ko-tyat-ki/universal-ear/static/images/desert.jpeg

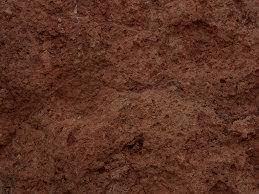
static/images/desert.jpeg
