ko-tyat-ki/universal-ear/static/images/moon.png

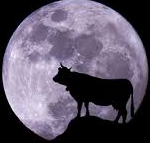
static/images/moon.png
