ko-tyat-ki/universal-ear/(commit log)

2019-02-23 Add initial arduino setup
    Reads data from the sensor, prints sensor to 9600, changes LEDs
    based on the information received from the sensor.
2019-02-23 PI Server + Arduino in passive mode
2019-02-25 Add server and refactor code
    Server runs on express with very minimal set up for now;
    Function connectArduinoWithColumn connects Arduino
    simulation with the drawn columns;
    Program is beign run on the closure.
2019-02-26 Two arduinos sends and receives through pi
    Sensors send information to pi and LEDs receive information from pi
    Two way communication!
2019-02-27 Add a switch to html
    Offers two options and does nothing.
2019-02-27 Increase number of LEDs to 40
2019-02-27 Introduce switch that listens to the dropdown value
2019-02-27 Separate basic function
    Now basic function works when the option is selected.
    Class column draws leds based on provided array of objects with
    { number, color } values.
2019-02-27 Update app.ino
    Arduino. Added averaging functions and sensor derivatives. Requires testing
2019-03-03 Arduino. Running average calculation for sensor value. Web. Flicker values.
    Revert "Revert "Update app.ino""
    This reverts commit d404375da9c8d9e6f374489f315d1ebb58280242.
    Revert "Revert "Added Flicker function""
    This reverts commit e40feee27a2ab2055a29b3580251ce642469ade0.
2019-03-03 First draft of client-server socket com
    Between python and pi server.js
2019-03-03 Add random echo
    Flickers on the column with the active sensor, and echos to other
    columns.
2019-03-03 Sensor interface added
2019-03-03 Add pi-brain/deives prototype
2019-03-21 Add heights to columns
    That correspond to sensors height.
    Basic function runs from that height.
2019-03-23 Tension and random echo (#16)
    * Initial commit for random tension with echo
    * Make them all the same brightness
2019-03-23 Server to process everything
    - added nodejs watcher to check for lates changes and restart server
    - added socket server to process sensor ignals and output led values
    - added babel to be able to write serverside and clientside logic in same dialect
    - moved client logic partially to serverside
    - separated static files from business logic
    - rewrote basic effect to comply
2019-03-23 Fix merges (#17)
    * fix random echo
    * fix tension and random tension
2019-05-19 3d visualisation for Poles (#20)
    * First step: copy example
    It works!
    Still lots of todos, from color picker, to connecting columns
    and lightning them up.
    * Looks like desert with LED lights
    * Tiny code remarks
    * Replace light with balls
    Can change color dynamiclly now
    Maybe will have to replce with something else
    Like small tube?
    * 3d reacts to keys!!! ♥️
    * Refactor
    Rename classes
    * Tiny refactoring
    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
2019-06-06 Added raspberrypi setup settings Deployment key for raspberrypi Lost Fastled lib for arduino
2019-06-06 * arduino reading * collection and preparation for processing * no web interface notification for now
2019-06-06 Arduino writes all data to output and reads l and c commands to set led to specific color Stuck with node infinite loop not giving execution time to serialport library
    [app-new.ino]
2019-06-06 Sensors katya (#19)
    * intermediary commit
    working:
    - client -> server
    - arduino -> console
    ???
    - arduino -> server
    - combine data
    * Intermediary commit
2019-06-06 Trying to make things work together Sirnyk driven development Now we read and write to arduino, BUT write works badly
2019-06-06 When we send 1 led on or off
2019-06-06 Clean leds every time
2019-06-06 Arduino byte arrays
    Arduino ping-pong with byte arrays.
2019-06-06 Bytearray ping-pong implementation
    Both arduino and node
    * for 3 leds
    * no checksum, no size yet
2019-06-06 Increase number of leds, add endbyte
2019-06-06 Bytearray ping-pong comms with 10 leds
    * 10 leds now, potential to increase up
2019-06-06 bytearray pingpong for 30 leds
2019-06-06 40 leds with only colors
2019-06-06 Output sensor data
2019-06-06 40 LEDs on the stick
2019-06-06 Adjust randomEcho and tensionAndRandomEcho
2019-06-06 You can see real sensors on real LED
2019-06-06 Simulating physical stretch sensor
2019-06-06 simulating physical sensor
    Make it go to 0
2019-06-06 Adjust LED positions on realistic
2019-06-06 Split client config into sensors, poles and sticks
2019-06-06 Split arduino config and connect to separate files
2019-06-06 Import socket.io locally
2019-06-06 Rename sensor into fakeSensor
2019-06-08 Remove measurements from code (#25)
    * Pass all sensor information through sockets
    * Remove measurements from basic
    Currently all updated information is already in sensors
    * Adjust other modes to new communication
    Now we pass to mode only sensors and sticks
    Which is awesome
2019-06-08 Improve fake sensor function
    Exponent is veeeery slow
2019-06-08 fake sensor fix slow jump
2019-06-09 Some small bug fixes in modes (#28)
    * Rename Stick into ClientStick
    * Clean from commented code
    * Decrease slow sensor simulation speed
    * Make fast sensor speed a bit slower
    * When ear is drawn sticks color is grey
    * Move config to not used
    * Make init color even better
    * This fixes blackout problems - interesting
    * Kinda fix for the tension
    Potentially will need better fix later on
    * Fix errors on client when randomEcho
    * Create different reaction on fast sensor
2019-06-09 Split tensionWIthEcho and fastReaction (#32)
    Now it seems that we have all the representative modes
2019-06-09 Previous tension (#35)
    * Add old tension
    * Smoothen previous tensions with rain
2019-06-09 Previous tension (#36)
    * arduino update
    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
2019-06-09 Real sensor class (#37)
    * First draft of the realSensor class
    * First try to integrate real sensor class
    Needed to be thoroughly tested with the live devices
    * Fix the merge conflicts
    * Basic does work
    * Flicker works as well
2019-06-09 Update README with more information (#33)
    * Update README with more information
    Modes description is still to come
    * Add gifs of the modes
    * Add information about modes function
    * Small typo
    * One more
    * More typos
    * readme tension update
2019-06-09 sensor old data updated
2019-06-14 Moved raspberry=pi os settings into deploy Fixed babel-node problem. dependencies were a mess. Added file with "ear" service description. Os will restart process autoatically. Not tested! [wip] Remov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
2019-06-15 Combine fake and real sensors (#38)
    * Improve regroupconfig
    * clean arduino sensors
    Combination wouldn't work until we decouple the sensor power and leds power
    * Working commit
    * Working version for mac!
    * Works both on real stick and simulation!
    * Tiny refactor
    * remove non-used function
    * Merge conflict
2019-06-16 Make work without client (#44)
    * Spacing, sorry
    * Make it work without trigger from the client
    Previously it couldn't start writing becase ledsConfig were undefined
    Right now we assign an initial config value of []
2019-06-16 Communicate with python (#43)
    Uses 'net' from node side and 'socket' in Python using port 8124.
    Writes a string with required data. Python reads string (this
    can be changes to buffer or Unit8Array if necessary.
    Code live is a separate helper file
2019-06-18 Add more arduino config for testing
2019-06-19 Ivan experiences (#46)
    * Rain updated
    * Updated Rain and Flicker
    * Smoothing LEDs between frames (arduino)
    * Smooth between 5-led-unit
    * some small fixes
    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
    [app-new-bytes.ino]
2019-06-23 Changes during party (#51)
    * Workaround for undefined stick in visualization
    Latest arduinosConfig:w
    * Delete non-used functions
    These function will be added as part of a separate PR
2019-06-23 Add missing bracket
2019-06-25 Fix getDistance
    Previous error was caused by real sensors attempting to connect to
    the client stick that is not there (e.g. more real sensors than client
    sticks)
2019-06-28 Fix bug with yanns mode (auto switch)
2019-06-28 Fix couple of weird bugs in python
2019-06-28 Fix undefined for fast of the real sensor
2019-06-28 change to LEDShtuka
2019-06-29 Ivan experiences / Arduinos (#53)
    * Arduino changes
    Updated slow and fast sensor data;
    Three sensors file created
    Old arduino files deleted
    * Remove slow settle-down period for restarting Arduinos
    * Three sensor Arduino. Refactoring
    * UV control; 3 sensors maximum output
    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
2019-06-30 New visuals (#57)
    * Add final structure
    * Add config for new sensors
    * Add jasmine
    * Remove non-used import
    * Add y to getDistance
    It will calculate the distance between centers of the sticks
    * Add ocean
    * Save if stick is not found
    * Linting
    * Improve randomFlashes
    * Some changes to randomFlashes
    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
2019-06-30 [hotfix] no prints in python
2019-06-30 Stairs visuals (#58)
    * Add stairs mode
    First version without color and tension
    Works only on duet and final
    * Add color function to stairs
    TBD: check how it looks on real arduinos
    Eliminate code repetition
    * Add tesnsion algorythm for 2 sticks
    * Add reaction to tension
    Fractal (lol)
    * Make it work in prod
    * Remove empty line
    * Some small tweaks
    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
2019-06-30 [hotfix] python reconnect to socket
2019-07-01 Separate modes config into the json file (#61)
    * Config fastReaction
    * Config basicWithRainbows
    * Remove basic from view
    * Config changingColors
    * Remove other not-used modes
    * Slightly change flicker
    * Config jasmine
    * Fix naming conflict
    * Add ocean config
    * Config polzunki
    * Hida rain as well
    * Config random flashes 2
    * Config random flashes
    * Config stairs
    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
2019-07-01 Automatic mode switching (#54)
    * Automatic mode switching
    Added api for turning on automatic mode switching and configure switch timeout
    * Fix bagchok
    * Change changeMode from get to post
    * Rename mode?mode to mode?name
    * Add arduinosStatusHandler
    * Wording
    * Remove comment
    * Add first easter egg
    * Add onChange WIP
    * OnChange very WIP
2019-07-01 On change (#62)
    * Add a first version of onChange
    * Add onChange to config
    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
2019-07-02 Prod arduinoConfig
    fingers crossed
2019-07-02 Fix for the server
    for the case when ledsConfig is empty at the beginning
2019-07-03 Easter egg (#63)
    * easter egg mode added
    previous mode tracking
    couple of crotches in automatic mode switching
    * Add easter config
    * Ooooops
    * Fix why real arduinos are not showing
    * Change slow to fast
2019-07-04 My refactoring of modes (#65)
    * - lite music, mp3
    * Added sleep tracker module that contains logic for tracking sleeping and waking up conditions
    added sleep mode (paint all into black)
    setup server callbacks for sleep and wake up
    * - jasmine
    * Clean modes we output to the client
    * We still need speep mode on the client
    * Tiny but of reshuffling
    * Make another auto change and sleep
    * Apply mode doesn't use any args
    * Add easterEgg
    * Fix the way sleep works
    * Add onChange mode
    * Remove comments and format
    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
2019-07-04 My refactoring of modes (#66)
    * Remove nont-used lines
    * Add easterEgg switch
    * Remove sleep from visualisation
    * Add sleepMode flag
    * Config real sticks
    * Remove empt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
2019-07-04 Attemps to improve (#68)
    * Don't separate calcs in a sep func
    * Comment out modes
    * Try to comment out python
    * Try to improve jasmine
    * Another attemps
    * Switch the python back
    * I think I fuckin fixed it!!!
    * Icrease randomness to 1000
    * Change mode every 3 minutes
    * Remove console.log
    * Keep tension positive check
    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
2019-07-05 control buttons on visualisation
2019-07-05 Add buttons style
2019-07-05 Supa mobile (#72)
    * Add buttons
    * Fix the mode change
2019-07-05 Fix bugs (#74)
    * Fix bug with the url mode switch
    * Ooops
2019-07-05 And a fix (#75)
    * Pythons print mode
    * Consistent naming
    * Haha ooops
2019-07-05 Not to mutate prodModes 😬
2019-11-08 Clean stairs mode
    Has special case for 2 sticks, and for other number of sticks work
    as if there are 12.
    Thus any structures < 12 will have this mode working
2019-11-08 Communicate change of structure through sockets
    Similar to the communication of the mode change
    By default is "nowhere2019". TODO: set default structure in
    config
